marceluphd/Prototype-PocketQube/Schematic/LoRaSAT Prototype Schematic.pdf

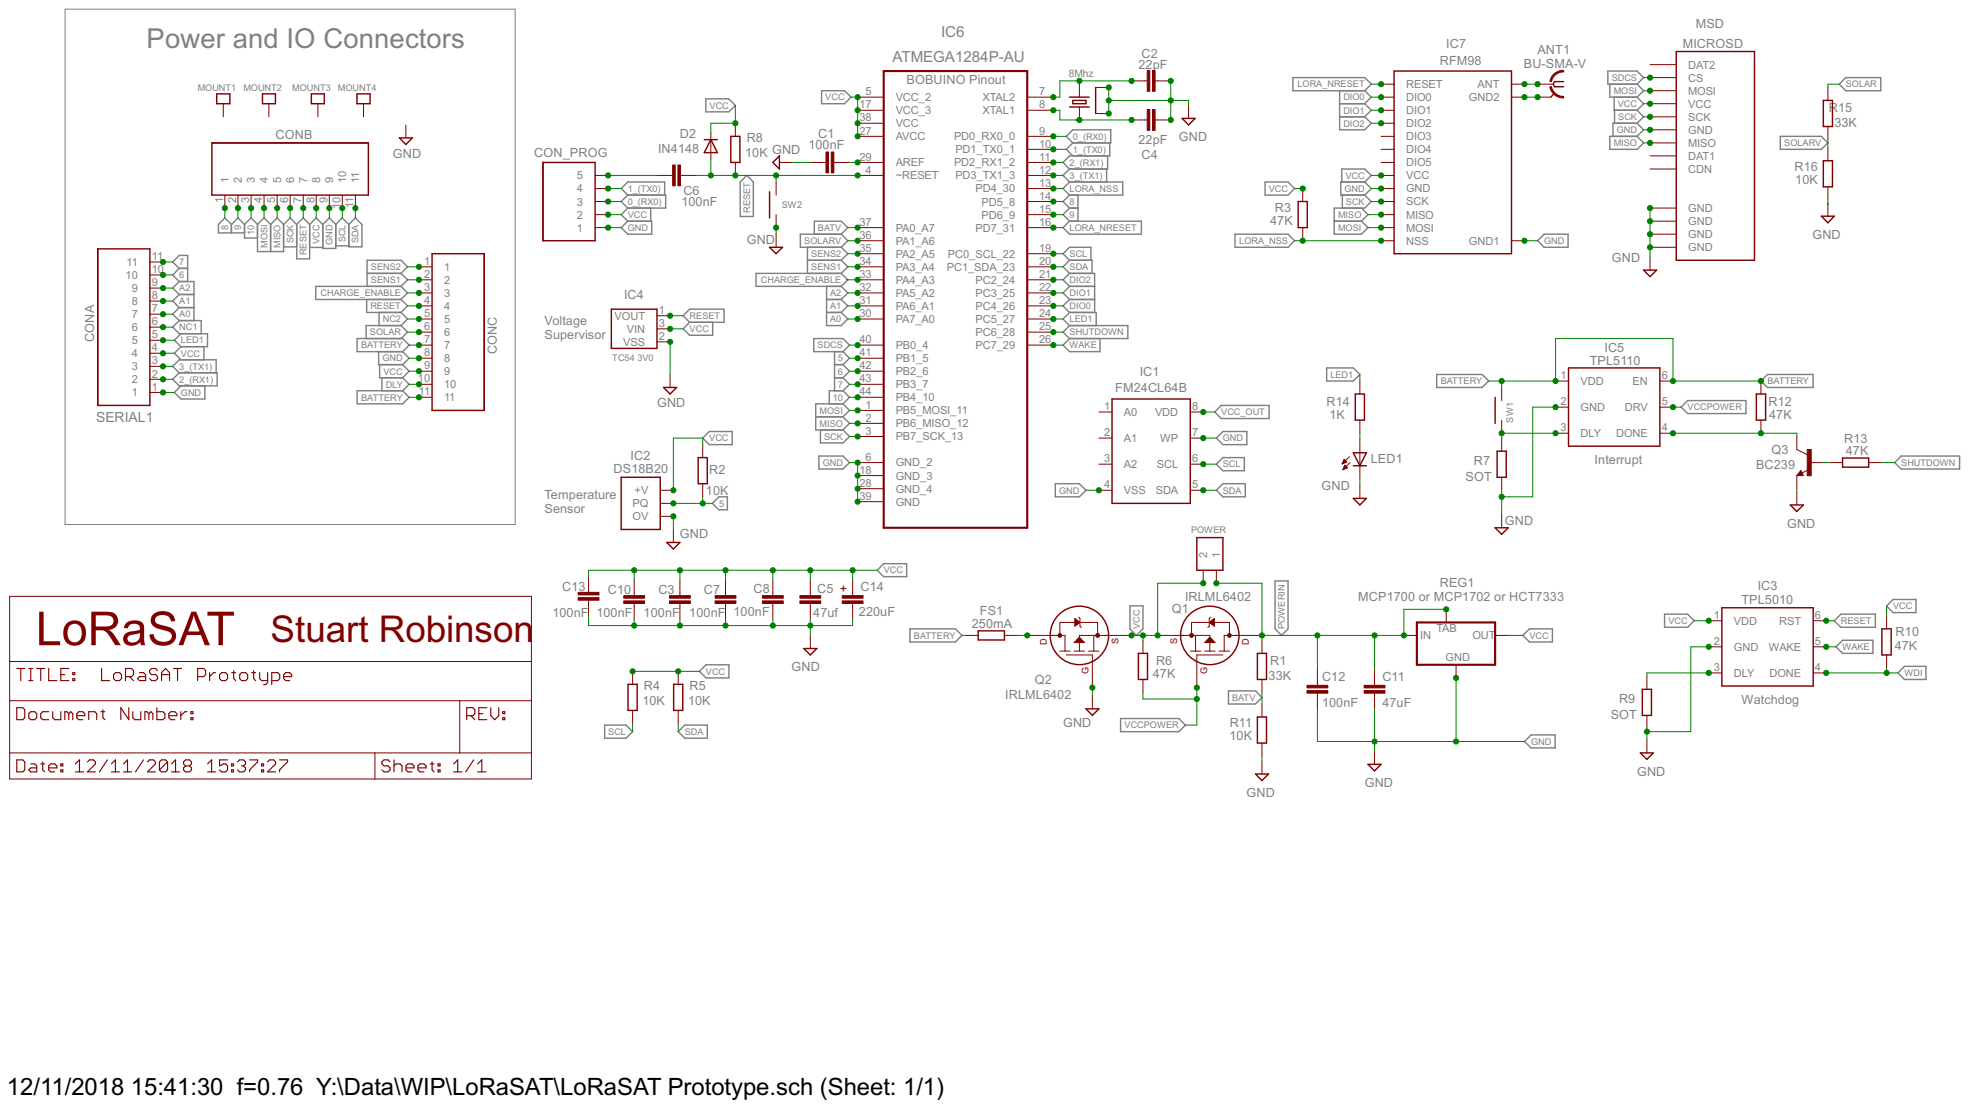
[picture p7: page 1]

Power and IO Connectors

SCK MISO MOSI NSS

GND GND

12/11/2018 15:41:30 f=0.76 Y:\Data\WIP\LoRaSAT\LoRaSAT Prototype.sch (Sheet: 1/1)
