marceluphd/Prototype-PocketQube/Board/LoRaSAT Prototype PCB.pdf

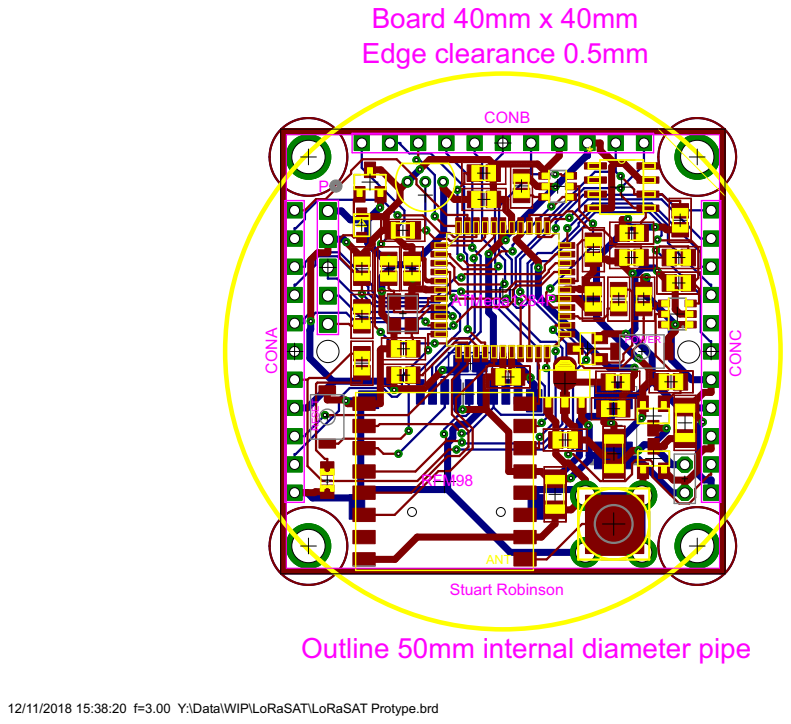
[picture p8: page 1]

Outline 50mm internal diameter pipe

12/11/2018 15:38:20 f=3.00 Y:\Data\WIP\LoRaSAT\LoRaSAT Protype.brd
